root50643/Solder-Reflow-Plate/Images/Dev Ver3.1 Photos/PXL_20241017_125950157.jpg

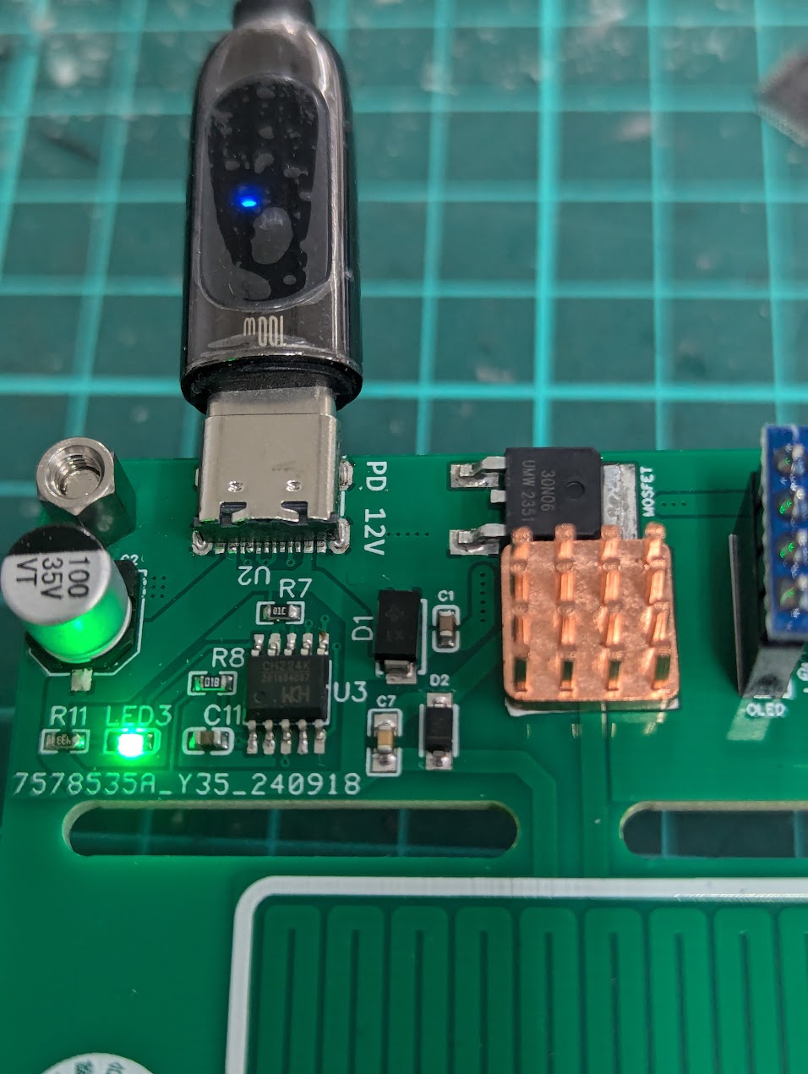
Images/Dev Ver3.1 Photos/PXL_20241017_125950157.jpg
