root50643/Solder-Reflow-Plate/Images/Dev Ver3.1 Photos/5V(AC).png

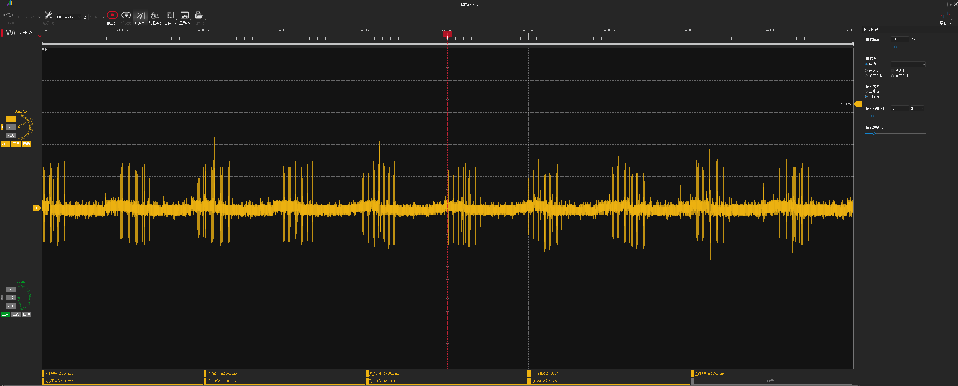
Images/Dev Ver3.1 Photos/5V(AC).png
