root50643/Solder-Reflow-Plate/Images/Dev Ver3.1 Photos/MOS(Vd).png

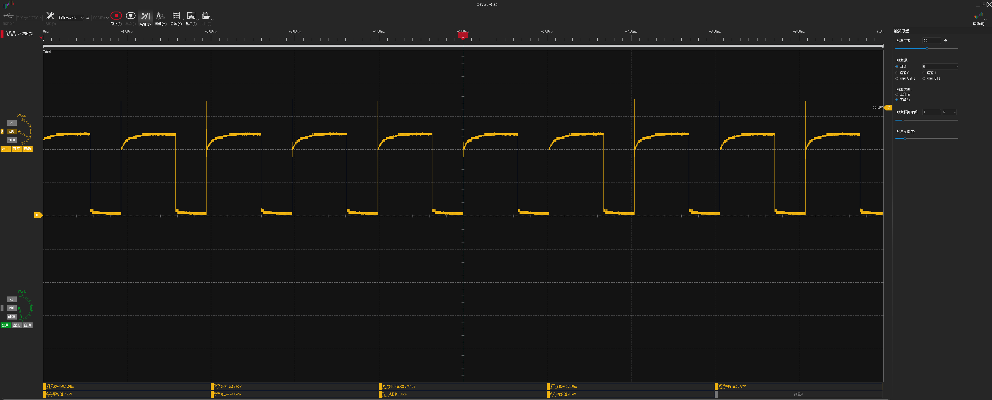
Images/Dev Ver3.1 Photos/MOS(Vd).png
