root50643/Solder-Reflow-Plate/Images/Dev Ver3.1 Photos/PXL_20241017_123505488.jpg

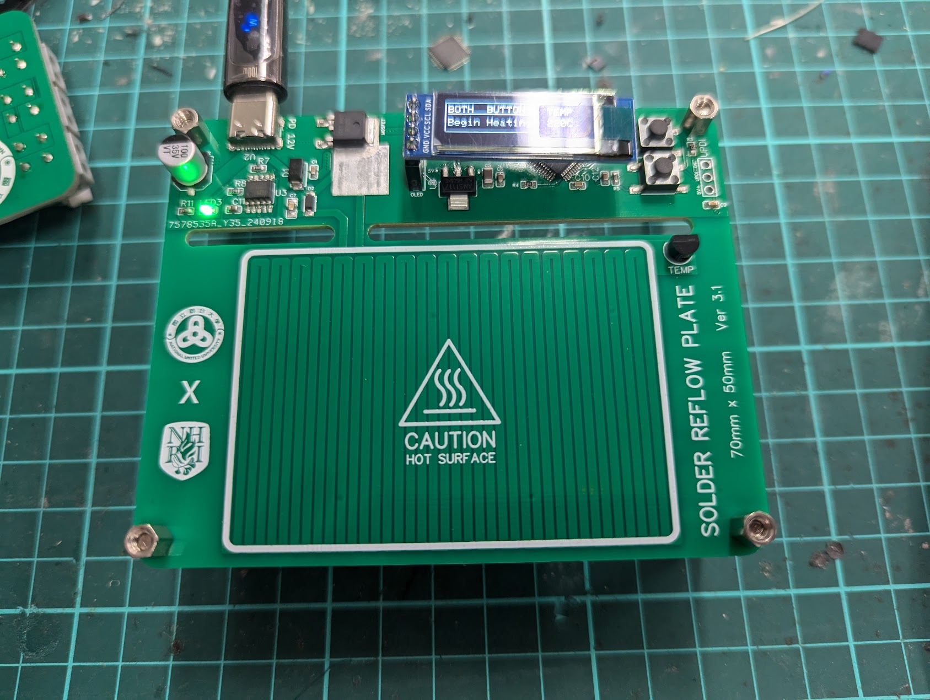
Images/Dev Ver3.1 Photos/PXL_20241017_123505488.jpg
