root50643/Solder-Reflow-Plate/Board Versions/70mm by 50mm Ver3.1 ATmega4809/Board Files/BOM_Solder-Reflow-Plate_3.1_2024-10-19.csv

ID | Name | Designator | Footprint | Quantity | Manufacturer Part | Manufacturer | Supplier | Supplier Part | Price
1 | 100nF | C1,C4,C6,C9,C19 | C0603 | 5 | 0603B104K250 | WTC | LCSC | C83054 | 0.003
2 | 100uF | C2 | CAP-SMD_BD6.3-L6.6-W6.6-LS7.6-FD | 1 | UWT1V101MCL1GS | Nichicon | LCSC | C125975 | 0.089
3 | 22uF | C3,C5 | C0805 | 2 | CL21A226MAYNNNE | Samsung Electro-Mechanics | LCSC | C602037 | 0.021
4 | 1nF | C7 | C0805 | 1 | FM21X102K501PXG | PSA(Prosperity Dielectrics) | LCSC | C440004 | 0.005
5 | 10nF | C8,C10,C12,C13,C14 | C0603 | 5
6 | 1u | C11 | C0603 | 1
7 | SMAJ18CA | D1 | SMA_L4.4-W2.6-LS5.0-BI | 1 | SMAJ18CA-HP6/TR13 | Brightking(君耀电子) | LCSC | C523218 | 0.06
8 | MM1Z24 | D2 | SOD-123_L2.8-W1.8-LS3.7-FD | 1 | MM1Z24 | SEMTECH | LCSC | C82522 | 0.016
9 | DSR1M_C908221 | D3 | SOD-123_L2.8-W1.8-LS3.7-RD | 1 | DSR1M | FUXINSEMI | LCSC | C908221 | 0.006
10 | LED-0603_G | LED3 | LED0603_GREEN | 1 | 19-217/GHC-YR1S2/3T | EVERLIGHT(台湾亿光) | LCSC | C72043 | 0.032
11 | UMW30N06 | MOSFET | TO-252-2_L6.6-W6.1-P4.57-LS9.9-BR-CW | 1 | UMW30N06 | Youtai Semiconductor Co., Ltd. | LCSC | C369599 | 0.114
12 | 3K | R1 | R0805 | 1 | RTT05302JTP | RALEC | LCSC | C104211 | 0.002
13 | 1K | R2 | R0805 | 1 | CR0805-FX-1001ELF | BOURNS | LCSC | C204136 | 0.011
14 | 4.7K | R3 | R0603 | 1 | AC0603JR-074K7L | YAGEO | LCSC | C144596 | 0.002
15 | 10K | R4,R5,R6 | R0603 | 3 | RTT03103JTP | RALEC | LCSC | C103210 | 0.001
16 | 10k | R7 | R0603 | 1
17 | 1k | R8 | R0603 | 1
18 | 43k | R11 | R0603 | 1
19 | BUTTON | SW1,SW2 | SW-SMD_4P-L6.0-W6.0-P4.50-LS8.2 | 2 | 6×6×5mm 环保（嘉立创） | null | LCSC | C21456
20 | LMT85LP | TEMP | TO-92-3_L4.9-W3.7-P1.27-L | 1 | LMT85LP | TI | LCSC | C75856 | 1.093
21 | ATMEGA4809-AFR | U1 | TQFP-48_L7.0-W7.0-P0.50-LS9.0-BL | 1 | ATMEGA4809-AFR | Microchip Tech | LCSC | C189475 | 3.108
22 | TYPE-C_16P | U2 | USB-SMD_TYPE-C16PIN | 1 | TYPE-C16PIN母座 板上四脚三次molding | null | LCSC | C9900000202
23 | CH224K | U3 | ESSOP-10_L4.9-W3.9-P1.0-LS6.0-TL-EP | 1 | CH224K | WCH(南京沁恒) | LCSC | C970725 | 0.487
24 | AMS1117-5.0 | U4 | SOT-223-3_L6.5-W3.4-P2.30-LS7.0-BR | 1 | AMS1117-3.3 | AMS | LCSC | C6186 | 0.136
25 | Header-Male-2.54_1x3 | UPDI | HDR-TH_3P-P2.54-V-M-1 | 1 | Header2.54mm 1*3P | BOOMELE | LCSC | C49257 | 0.015
