root50643/Solder-Reflow-Plate/Board Versions/70mm by 50mm Ver3.1 ATmega4809/Board Files/Schematic_Solder-Reflow-Plate_3.1_2024-10-19.pdf

## Temp Measurement

## Max input 18V

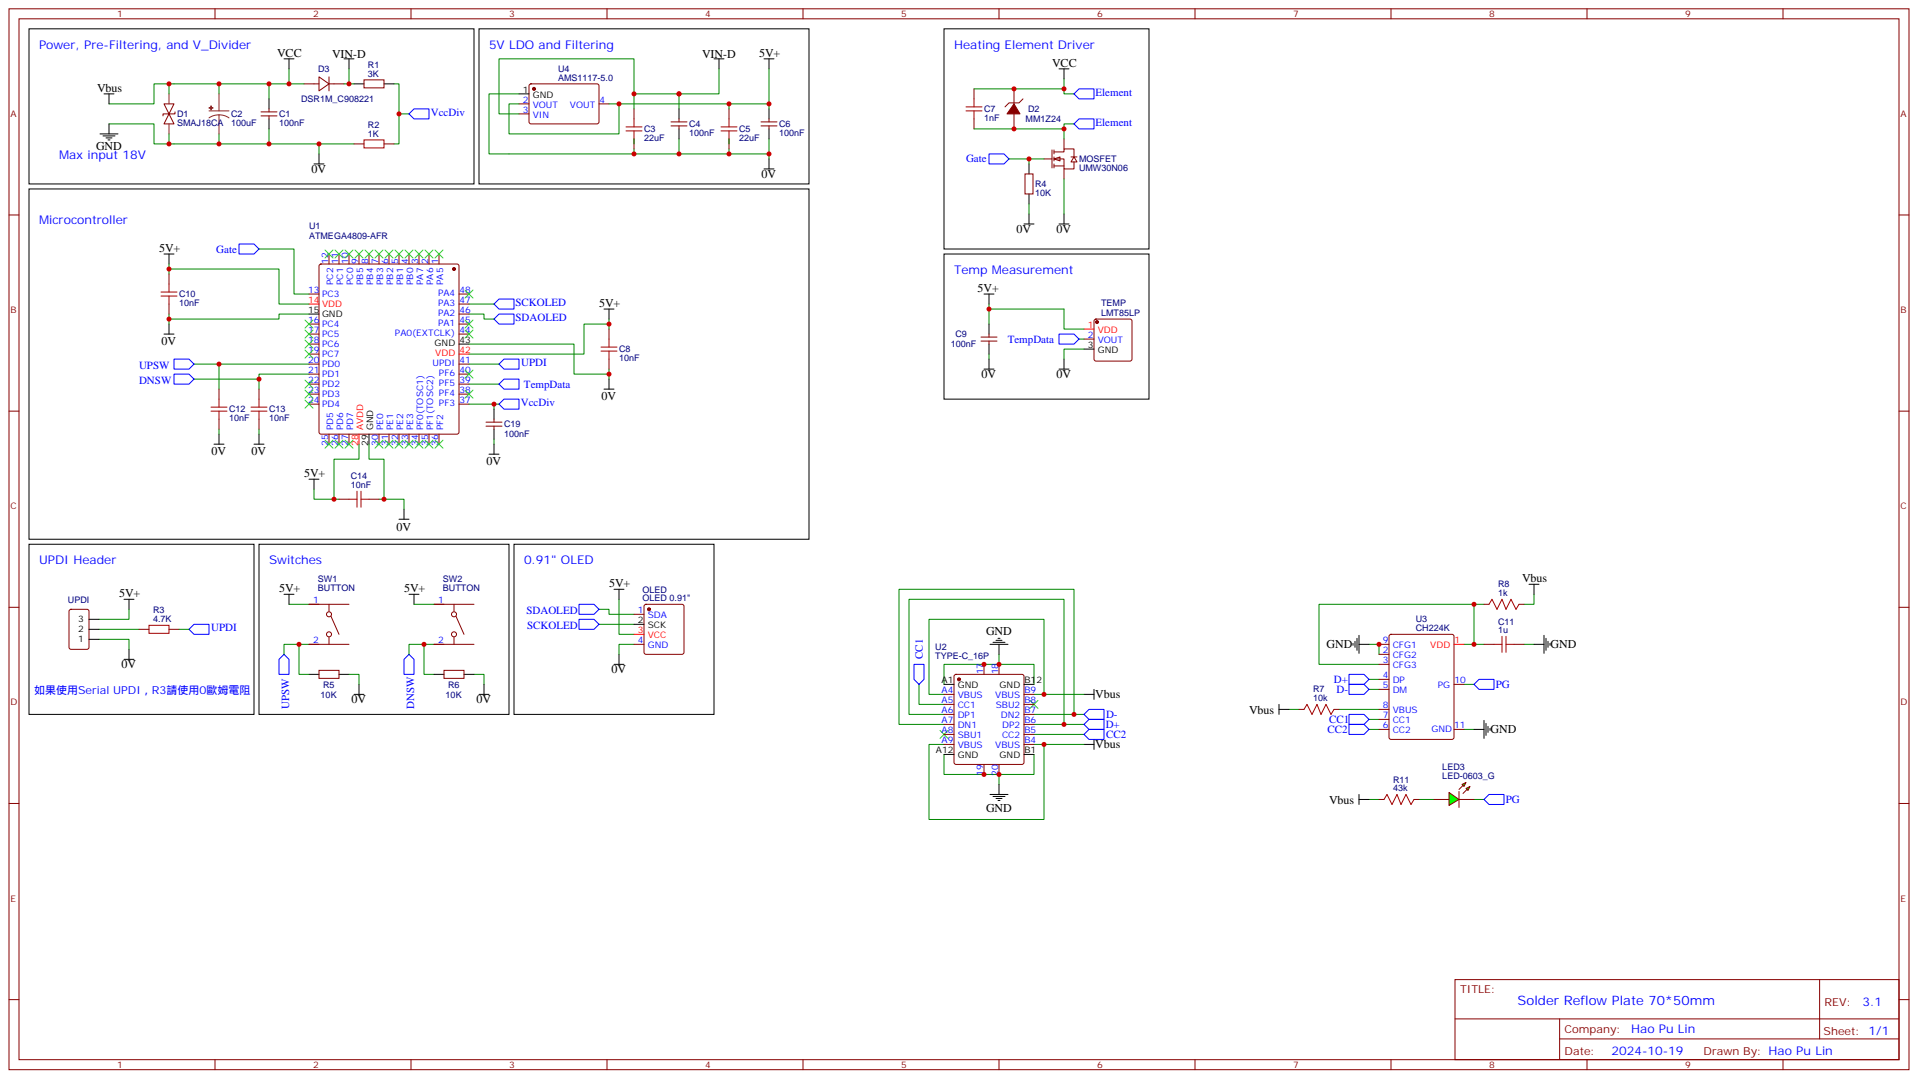
[picture p8: page 1]

Power, Pre-Filtering, and V_Divider

Company: Hao Pu Lin

Drawn By: Hao Pu Lin
