root50643/Solder-Reflow-Plate/(list of files, drawings)

Other design files:
Board Versions/70mm by 50mm Ver3.1 ATmega4809/Board Files/PCB_PCB_SRP-70-50mm_1_2024-10-19.json
Board Versions/70mm by 50mm Ver3.1 ATmega4809/Board Files/SCH_Solder-Reflow-Plate_3.1_2024-10-19.json
