root50643/Solder-Reflow-Plate/(commit log)

2024-10-19 新增V3.0圖片及韌體
2024-10-19 加入3.1版本，使用USB PD供電
    [BOM_Solder-Reflow-Plate_3.1_2024-10-19.csv, PCB_PCB_SRP-70-50mm_1_2024-10-19.json, SCH_Solder-Reflow-Plate_3.1_2024-10-19.json]
